ivan-kalachikov/telehaptic/docs/screens/2-home-not-found.png

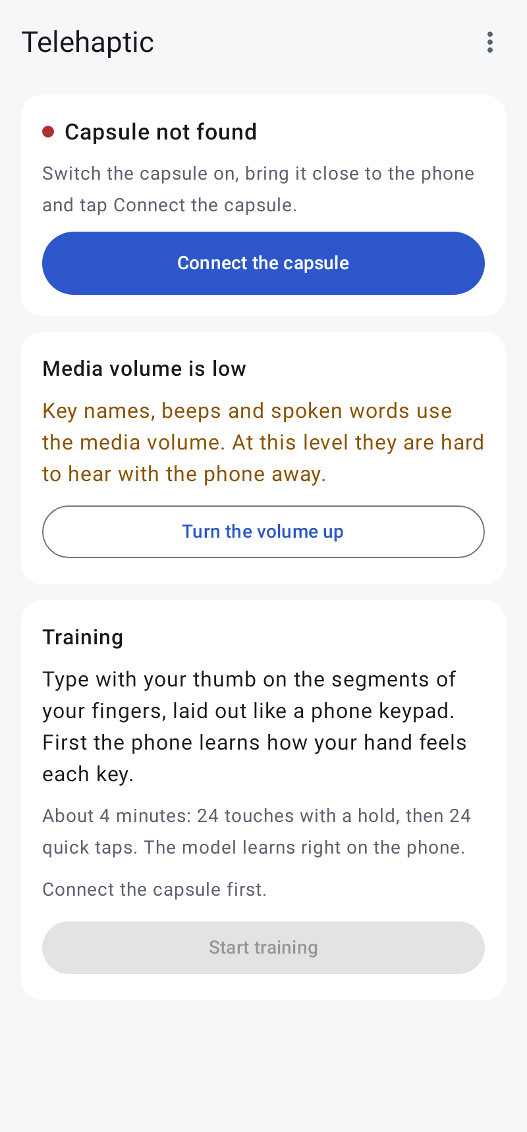
docs/screens/2-home-not-found.png
