ivan-kalachikov/telehaptic/docs/screens/5-run-keys.png

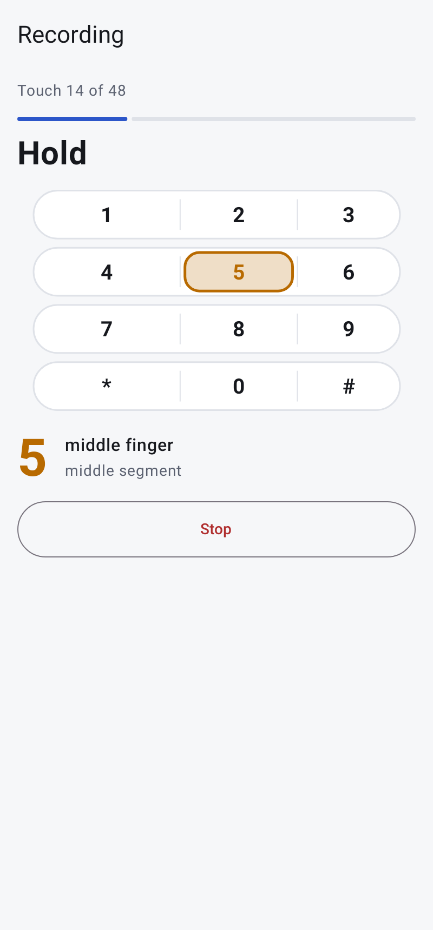
docs/screens/5-run-keys.png
