ivan-kalachikov/telehaptic/docs/screens/7-done.png

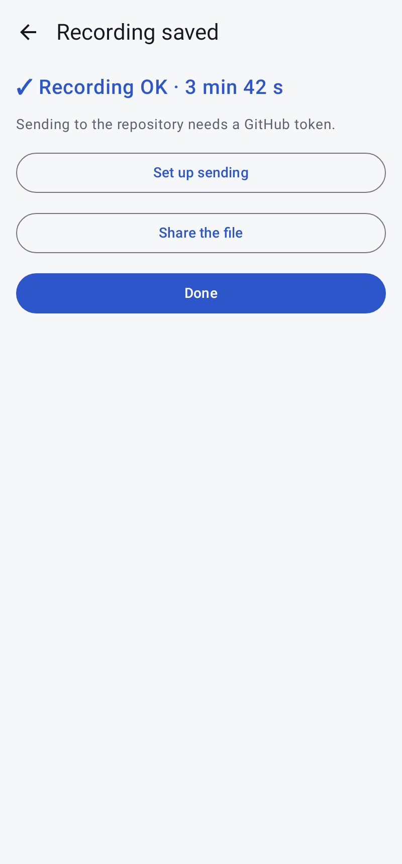
docs/screens/7-done.png
