ivan-kalachikov/telehaptic/docs/screens/8-diagnostics.png

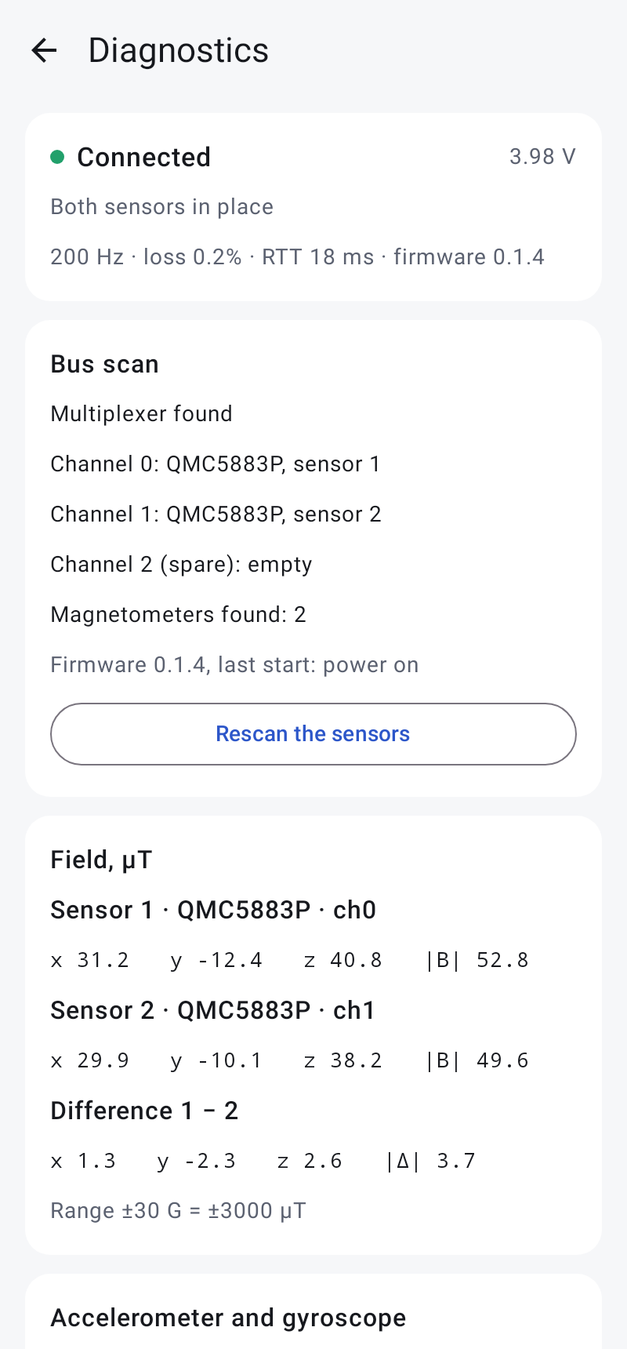
docs/screens/8-diagnostics.png
