ivan-kalachikov/telehaptic/docs/screens/9-home-trained.png

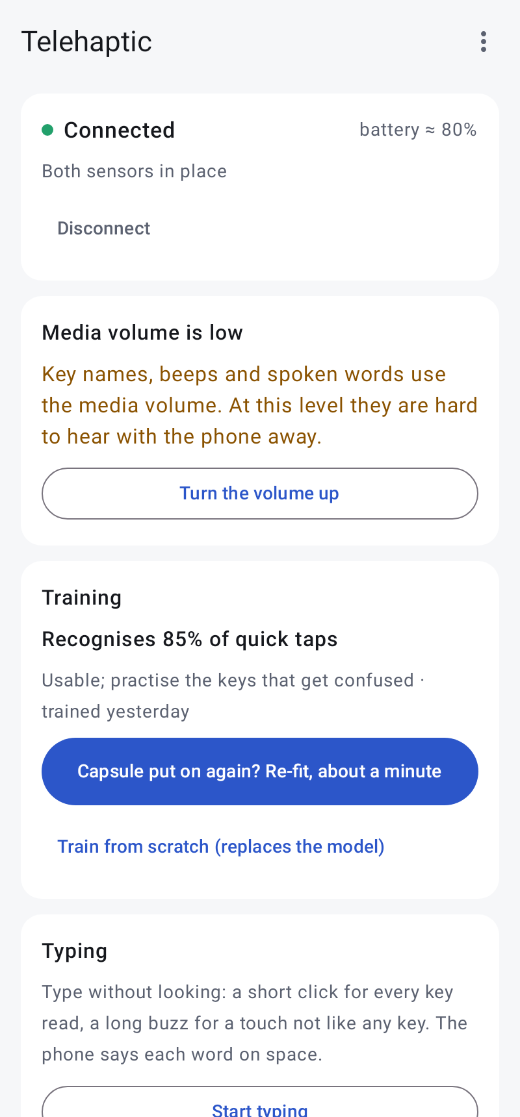
docs/screens/9-home-trained.png
