ivan-kalachikov/telehaptic/hardware/capsule_assembly_preview.stl

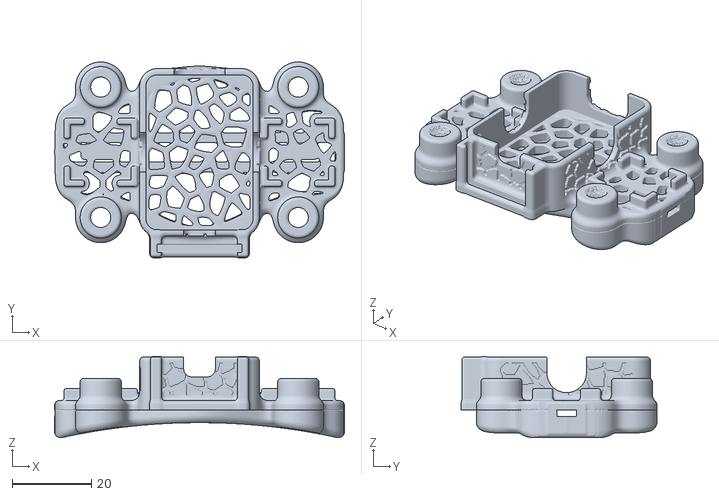
[picture p10: CAD file, 2026-11-09]
hardware/capsule_assembly_preview.stl
73.4 x 49.6 x 20.6
