ivan-kalachikov/telehaptic/hardware/capsule_saddle.stl

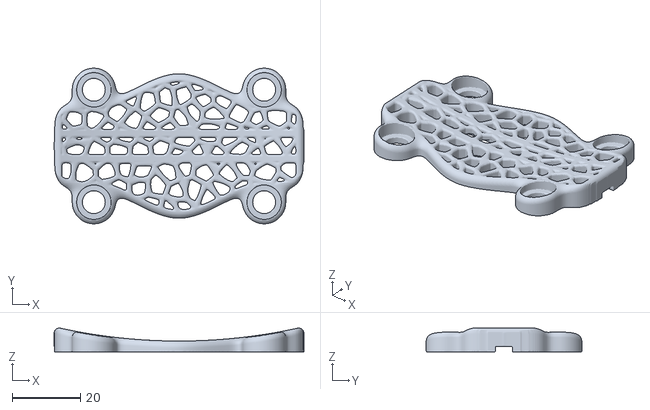
[picture p11: CAD file, 2026-11-09]
hardware/capsule_saddle.stl
73.4 x 45.7 x 7.00
