ivan-kalachikov/telehaptic/hardware/capsule_base.stl

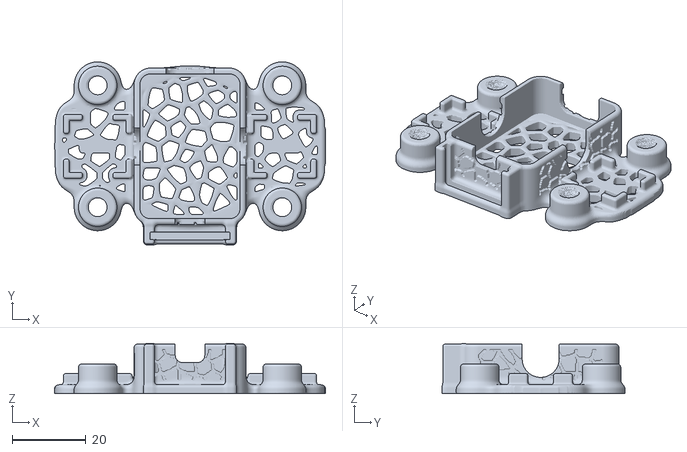
[picture p12: CAD file, 2026-11-09]
hardware/capsule_base.stl
73.4 x 49.6 x 13.6
