ivan-kalachikov/telehaptic/hardware/capsule_screws.stl

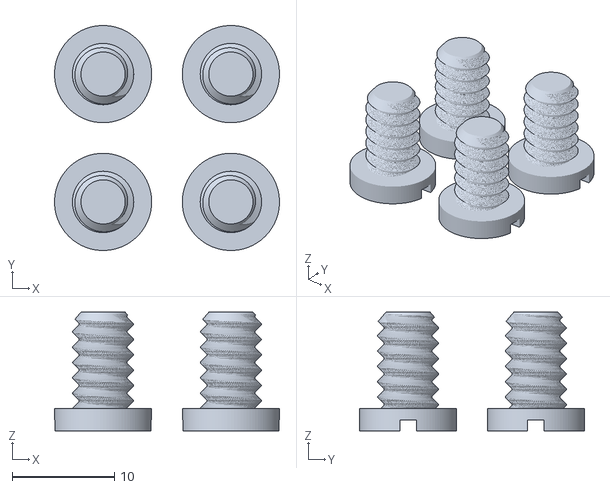
[picture p13: CAD file, 2026-11-09]
hardware/capsule_screws.stl
22.0 x 22.0 x 11.6
