ivan-kalachikov/telehaptic/docs/screens/4-setup-keys.png

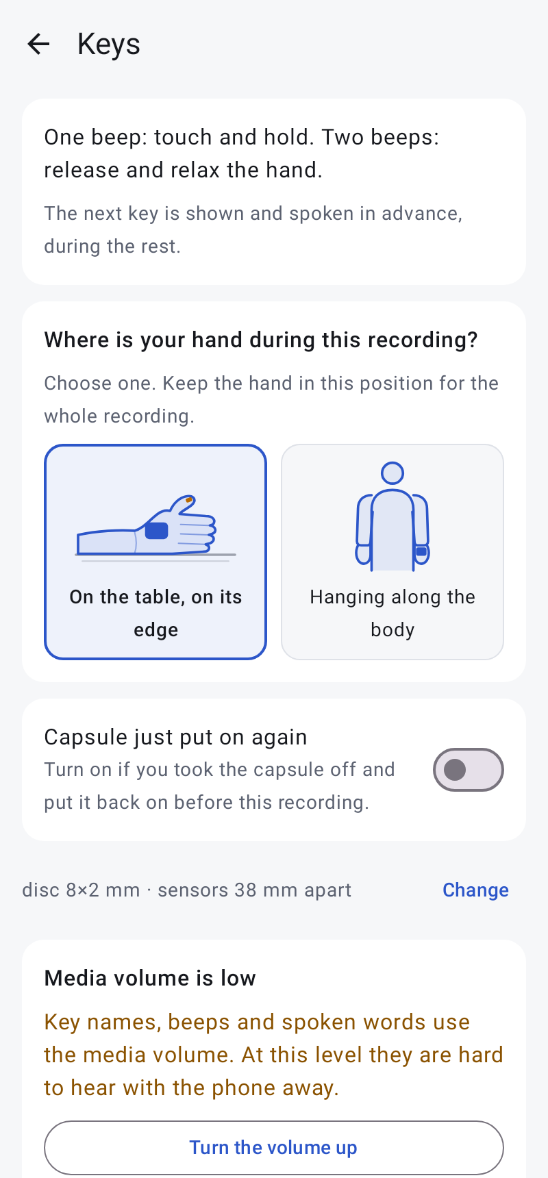
docs/screens/4-setup-keys.png
