ivan-kalachikov/telehaptic/docs/screens/3-experiments.png

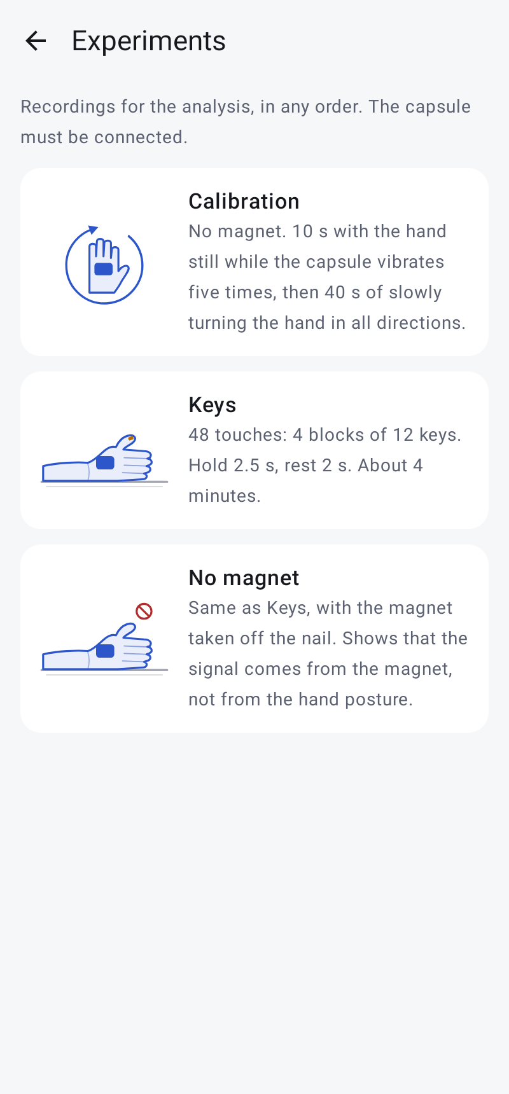
docs/screens/3-experiments.png
