ivan-kalachikov/telehaptic/docs/screens/6-run-calibration.png

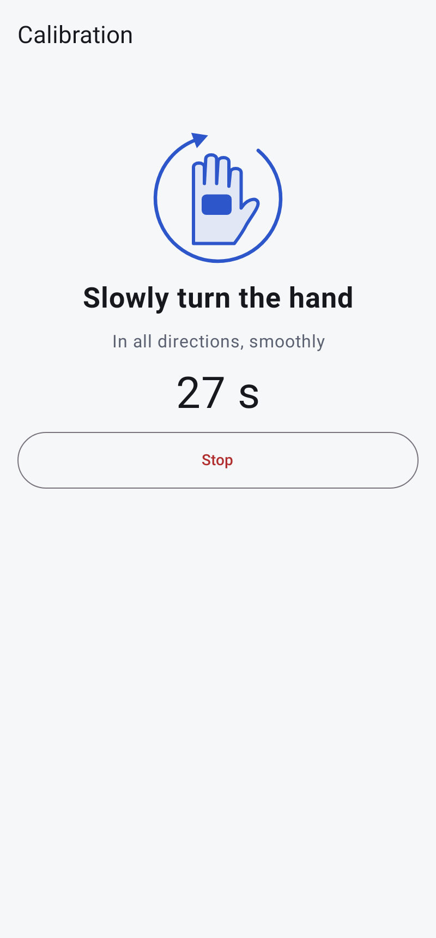
docs/screens/6-run-calibration.png
