ivan-kalachikov/telehaptic/docs/screens/12-retrain-result.png

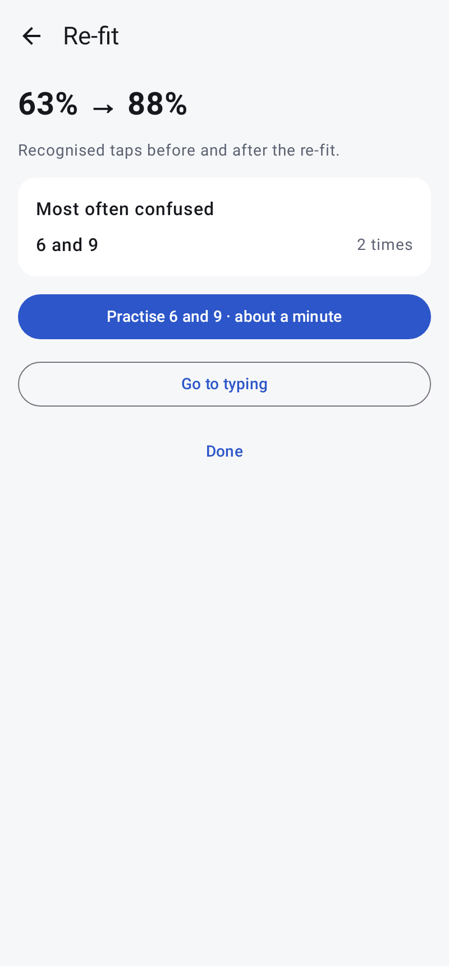
docs/screens/12-retrain-result.png
