ivan-kalachikov/telehaptic/(commit log)

2026-11-05 Firmware: scan, sampling, BLE stream, motor, battery; CI builds .uf2
    - Scans the main bus and every TCA9548A channel, identifies QMC5883P / QMC5883L
    - Reads all magnetometers and the on-board IMU on one RTC2 tick (100 Hz default)
    - BLE service with DATA / CTRL / INFO, sample indices for loss counting
    - Motor pulse on command, marked in the stream; battery every 5 s
    - GitHub Actions compiles with arduino-cli and converts .hex to .uf2
    Claude-Session: https://claude.ai/code/session_01F5j466bbtpUkmFb5iPJXPh
2026-11-05 Firmware: check I2C lines before scanning, report reset reason and a stopped clock
    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
    [sensors.cpp, telehaptic.ino]
2026-11-05 Android app, part 1: capsule link, diagnostics, experiments, upload to the repo
    - Kotlin + Compose, minSdk 33, target 36; fixed debug key so builds install over each other
    - BLE: scan by service UUID, auto-reconnect, MTU 247, notifications, GATT op queue
    - Stream parsing, loss counting, clock sync (lower envelope + drift), pings for RTT
    - Experiments: calibration with motor pulses, keys (table / down, rewear), no magnet
    - Recording zip: samples, events, packets, sync, info csv + meta.json
    - Upload to data/ via the GitHub contents API; logs screen with share / upload
    - Pure Kotlin core with unit tests; CI builds the APK next to the .uf2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
    [Capsule.kt, CoreTest.kt]
2026-11-05 App, part 2: training, retraining, typing with T9
    - Touch detector: plateau in the sensor difference, gyro gate, rest follows slow drift
    - LDA with shrinkage on the phone; honest report on held-out quick taps
    - Training: 24 cued holds, then 24 quick taps found by the same detector as typing
    - Retraining after rewear: common shift of old touches, before / after on new taps
    - Typing: T9 on the FrequencyWords Russian list (CC BY-SA 4.0), motor click per accepted touch,
    erase-then-retype kept as corrections, added to training after confirmation
    - Screenshots of the new screens
    Claude-Session: https://claude.ai/code/session_01F5j466bbtpUk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
    [Engine.kt, Plan.kt]
2026-11-05 Analysis, synthetic data generator, build-day guide
    - analysis/analyze.py: stream quality, 12-key recognition for sensor 1 / 2 / both / difference
    (LDA, kNN, LogReg, MLP) within a recording, after re-wearing, in another posture; calibration
    of each sensor and of the pair with the Earth field left in the difference; no-magnet control;
    motor effect at rest; accelerometer jolt at the touch
    - tools/make_fake_data.py: synthetic recordings in the app format, only for testing the analysis
    - docs/build-day.md: multimeter checks, flashing, what the app should show, what to do if a sensor is missing
    - CI runs the analysis on synthetic data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
2026-11-05 Default sampling 200 Hz: more accelerometer points at the jolt of a touch
    The phone stand is no reference for the jolt: the phone was held by the other hand and the
    touches were very gentle.
    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
2026-11-05 Translate everything to English; English T9; keypad diagram in the README
    - App UI, voice cues, notifications and error messages in English
    - T9 on the English FrequencyWords list (CC BY-SA 4.0) with the standard 2 abc ... 9 wxyz keypad
    - Docs, analysis report, release notes in English
    - docs/keypad.svg: which phalanx is which key; screenshots re-rendered
    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
    [CoreTest.kt]
2026-11-05 Keypad diagram: hand turned so the keys sit as on a phone, letters on the keys, sensors drawn on the hand; caption in the README
    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
2026-11-05 Review fixes, training-tap analysis, app keypad like a phone
    Firmware
    - fresh time after slow commands (rescan, range, averaging) for samples, PONG and the motor
    - INFO lines in their own queue; USB Serial never blocks; I2C at 100 kHz for bring-up
    - stall monitor task restarts the board when sampling stops for 2 s (no WDT, flashing unaffected)
    App
    - BLE: one discovery and one setup per connection, discovery even without an MTU answer,
    a single ping loop, link-down only after a real link; notices for MTU and version mismatch;
    status re-request when the sensor list is out of date; auto-connect at launch
    - foreground service always calls startForeground before stopping
    - recordings: no dou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
    [Capsule.kt, Engine.kt]
2026-11-05 Posture as a clear choice with new pictures, keypad without the palm block, success in the accent colour; fix firmware build (stall monitor after the declarations)
    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
    [Plan.kt, telehaptic.ino]
2026-11-05 Line illustrations for postures, calibration and no-magnet; arrowhead along the arc
    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
2026-11-05 Second review round: fixes in firmware, analysis and app; motor masked in IMU metrics
    Firmware: one command per loop pass; stall monitor only with a running clock; I2C bus check with
    pull-ups and 9-clock recovery; honest wording of a software reset.
    Analysis: no crash when a recording ends on a plateau; one common radius for both sensors in the
    calibration (the Earth residual was overstated); accelerometer peaks over equal-length windows;
    motor-on samples left out of jolt metrics; motor effect on the accelerometer and gyroscope;
    redone holds dropped; cued taps without a detection counted.
    App: re-fit check without leaking the test tap; equal windows for rate and loss; a worse re-fit
    keeps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
    [CoreTest.kt, Engine.kt]
2026-11-06 Third review round: end-to-end test with a fake capsule, firmware robustness, honest reject threshold, hands-free UX
    - Motor switched off by a FreeRTOS one-shot timer: a slow command after MOTOR no longer stretches the pulse.
    - Samples per packet fit the negotiated MTU, so a packet is never split into notifications the app cannot parse.
    - A sensor or multiplexer that lost power is configured again after 100 failed or stale reads (counted in STATS recover=).
    - Wire.end() before the SCL recovery clocks; IMU keeps its last good values on a read error (new flag bit 14); BDU set.
    - Stall monitor also watches setup(); scan lines buffer sized for the worst case; MOTOR without length answer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
    [Capsule.kt, CoreTest.kt, EndToEndTest.kt]
2026-11-06 Fourth review round: honest link state, spoken corrections, accessibility, robust analysis
    - Modes listen to one "usable" event: data arriving or not. A reconnect without data is no longer announced as
    "back", a stall followed by a disconnect is one alert, and a loss during the resume countdown cancels it.
    - Missed quick tap: spoken hint with the key, then the key moves to the end; no silent waiting.
    - Re-fit and typing start with "hand relaxed" before the rest level is measured; holds take the rest level right
    before the press, after the previous lift-off.
    - Fresh rest guard counts only an unbroken still period near a key.
    - Typing: erase after a space goes back into the word; the p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
    [Capsule.kt, EndToEndTest.kt, FakeCapsule.kt]
2026-11-09 Printed capsule base: parametric generator and STL
    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
    [capsule_base.stl]
2026-11-09 Capsule base: room for wires and solder joints, open sensor pockets, taller tray
    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
    [capsule_base.stl]
2026-11-09 Capsule saddle: curved underside that follows the back of the hand, flat top keeps the sensors parallel
    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
    [capsule_saddle.stl]
2026-11-09 Capsule parts as smooth organic shapes: rounded edges, Voronoi lattice saddle, strap in a channel, 73 mm across the hand
    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
    [capsule_base.stl, capsule_saddle.stl]
2026-11-09 Capsule: flat 40x30x3 battery on top of the tray as a lid; base 13.4 mm high
    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
    [capsule_base.stl]
2026-11-09 Capsule: measured part sizes (XIAO 23 x 17.8, TCA9548A 21 x 21, battery 42 x 30 x 3)
    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
    [capsule_base.stl, capsule_saddle.stl]
2026-11-09 Capsule: multiplexer back to 30.5 x 21 (21 x 21 was the motor board)
    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
2026-11-09 Capsule: motor board holder on the wrist-side wall, switch window, wire notch
    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
    [capsule_base.stl, capsule_saddle.stl]
2026-11-09 Capsule: measured switch (11 x 6 x 13) stands upright, vertical lever window
    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
    [capsule_base.stl]
2026-11-09 Capsule: open Voronoi lattice in the base plate (cells shared with the saddle), relief on the tray walls, assembly preview
    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
    [capsule_assembly_preview.stl, capsule_base.stl, capsule_saddle.stl]
2026-11-09 Capsule: printed screws, flat bottom, 5 mm strap channel, Orca presets (#6)
    * Capsule: four printed snap pins hold the saddle to the base instead of glue
    * Capsule: printed slotted screws with a coarse thread instead of snap pins
    * Capsule: sink screw heads below the curved skin on a flat pocket floor
    The hand side of the saddle is curved, so a pocket floor that followed it
    let the head rock and left one edge 0.5 mm proud. The floor is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
    [capsule_assembly_preview.stl, capsule_base.stl, capsule_saddle.stl, capsule_screws.stl]
